LateNightIceCream/ample/docs/hardware/README.md

# Hardware Concept
## Starting Point / Motivation
- Tensai 'Amplifier System 55'

## Requirements
- [ ] >=15W speaker output for at least two speakers (L/R)
- [ ] headphone output
- [ ] volume control
- [ ] front power button
- [ ] source selection
  - line input (single ended)
  - S/PDIF input
  - (maybe) Bluetooth input
- [ ] Microcontroller
- [ ] some LEDs

### Optional
- [ ] reuse tensai transformer
  - its very heavy and takes up a lot of space!
- [ ] Bluetooth input
- [ ] keep input / user interface in direction of uC extendable
- [ ] configuration jumpers on back of case
- [ ] DC input jack

### Case
- either a new wooden case or original Tensai case (bad for BT signal)

## Realization
### ICs

### Block Diagram

### Supply
- make sure to use ferrite beads + caps to decouple individual codec supplies

#### Voltage Levels
| Voltage  | Description |
|---|---|
| 230 VAC  | wall |
| 20.7 VAC | transformer secondary |
| 17 V | class D amplfier voltage |
| 5 V | codec supply |
| 3.3 V | codec supply |
| 3.3 V | uC voltage |

#### Input Current
