LateNightIceCream/ample/docs/hardware/review/README.md

# Hardware Review

## Component Checks
| Component | Symbol | Footprint | Checked | Eng | Note |
|---|---|---|---|-----|---|
| CS42528 | OK | OK | 2022-06-02 | RG  | |
| | NC | | | | |
| | | | | | |

| Abbr. | Meaning |
|---|---|
| OK | Symbol/Footprint was checked and is correct |
| NC | Not Checked |
| NOK | Symbol/Footprint is erroneous |
