LateNightIceCream/ample/docs/hardware/components/opamp/opamp_research.ods

Sheet: opamp
LDO
Requirements
Vin_max | >= 6 V
GBWP | >= 5 MHz
Slew Rate | >= 0.1 V/µs
Differential inp. Voltage | >= 5 V
 |  |  |  |  |  | Noise | RTR | THD | Offset (max)
PartNr | Price | Vin_max | GBWP | Slew Rate | D.inp. Voltage | nV/sqrtHz |  | % | mV
BA4560FJ-GE2 | 0.48 |  | 10 | 4 | 36 | 8 | no | 0.003 | 2.5
LM833DT | 0.57 | 15 | 10 | 7 | 30 | 4.5 | ? | 0.002 | 5
LM4565F-GE2 | 0.45 |  | 10 | 5 | 16 | 5 | ? | 0.0002 | 1.5
NJM4580E | 0.67 | 15 | 15 | 5 | 30 |  | ? | 0.0005 | 3
RC4580QDRQ1 | 0.67 | 15 | 12 | 5 | 30 | 0.8 | ? | 0.0005 | 3
LM833MX/NOPB | 0.89 | 15 | 12 | 5 | 30 | 4.5 | ? | 0.002 | 5
NJM2068 | 0.57 | 15 | 19 | 6 | 30 |  |  | 0.001 | 3 | (reference design)
References
https://www.digikey.de/en/products/filter/linear-amplifiers-instrumentation-op-amps-buffer-amps/687

Sheet: price
part | description | unit price | amount | total price
 |  |  | 3
 |  |  |  | 0
