LateNightIceCream/ample/docs/hardware/components/supply/dcdc_research.ods

Sheet: converter
DC/DC Buck
Requirements
Vin_max | >= 30V
Vout_min | <= 6V
I_out_max | >= 1.7A
f_sw | <= 1 MHz
Parts
PartNr | Price | Vin_max | Vout_min | I_out_max | f_sw / kHz
NCP1587DR2G (https://www.mouser.de/ProductDetail/onsemi/NCP1587DR2G?qs=N5dOQkml4H%252BYCA0xD3fSJw%3D%3D) | 0.836 | 12 | 0.8 |  | 200
NCP3011DTBR2G (https://www.mouser.de/ProductDetail/onsemi/NCP3011DTBR2G?qs=lYuAOLy5nvYYiiWQwbTD2w%3D%3D) | 1.32 | 28 | 3.3 |  | 400 | Fixed 3.3
TPS64203DBVR (https://www.mouser.de/ProductDetail/Texas-Instruments/TPS64203DBVR?qs=Gse6rAGbi78DSy0ANXesIQ%3D%3D) | 1.6 | 6.5 | 1.2 |  | 800
NCV3011DTBR2G (https://www.mouser.de/ProductDetail/onsemi/NCV3011DTBR2G?qs=Pqj8oIac8rVYum8f0f%252BPYA%3D%3D) | 1.59 |  |  |  |  | Fixed 3.3
TL5001IDR | 1.73 | 40 |  |  |  | controller
946-MP4423GQ-P | 2.94 | 30 | 0.8 | 3 | 410
L5972D | 3 | 36 |  | 2 | 250
NR111E | 1.63 | 31 | 0.8 | 4 | 350
AOZ1283PI | 1.72 | 36 | 0.8 | 2.5 | 200..2000 | adjustable fsw
RT7272BGSP | 2.09 | 36 | 0.8 | 3 | 500
RT7272AGSP | 2.09 | 36 | 0.8 | 3 | 500
RT8289GSP | 2.45 | 32 | 1.222 | 5 | 500
R1270S001A-E2-FE | 2.67 | 34 | 0.8 | 3 | 300..2400
MP9943AGQ-P | 2.7 | 36 | 0.8 | 3 | 410
R1276S001A-E2-FE | 2.7 | 30 | 3.15 | 3 | 250..1000
R1276S004A-E2-FE | 2.7 | 30 | 0.7 | 3 | 250..1000
MP4420GJ-P | 2.73 | 30 | 0.8 | 2 | 410
Shortlist
AOZ1283PI | RT7272BGSP
soft start | no diode needed
adjustable frequency | adjustable current limit
vin pad
References
https://octopart.com/search?category_id=4312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
https://www.digikey.de/de/products/filter/pmic-spannungsregler-dc-dc-schaltregler/739

Sheet: inductance
RT7272BGSP
Inductor Value 1 | 30.6944444444444 | uH
Input Voltage | 30
Output Voltage | 17
f_sw | 500000
I_max | 2
Saturation Current | 5
Inductor Value 2 | 48.28797190518 | uH
Input Voltage | 17
Output Voltage | 6
f_sw | 500000
I_max | 0.67
Saturation Current | 3
Parts
Inductor 1
PartNr | Price | L | I | I_sat
104CDMCCDS-330MC | 1.04 | 33 | 4.1 | 5.2
ETQ-P4M330KVC | 1.22 | 33 | 4.2 | 5.6
PA4342.333NLT | 1.37 | 33 | 3.5 | 5
DR127-470-R | 1.44 | 47 | 2.95 | 5.28
Inductor 2
PartNr | Price | L | I | I_sat
HCM1A0805-470-R | 0.49 | 47 | 1.8 | 3.2
IHLP4040DZER470M1A | 0.8 | 47 | 3.3 | 3
104CDMCCDS-470MC | 0.53 | 47 | 3.2 | 4.3
References
https://www.digikey.de/de/products/filter/feste-drosselspulen/71

Sheet: capacitance
Input Capacitance | 2x 10uF
I_RMS 1 | 0.991071249821234 | A
I_max | 2 | A
V_out | 17 | V
V_in | 30 | V
I_RMS 2 | 0.320182690065064 | A
I_max | 0.67 | A
V_out | 6 | V
V_in | 17 | V
Output Capacitance | 7.5 | uF
ESR | 0.05 | Ohm
Current Ripple | 0.6 | A
Voltage Ripple | 0.01 | V
f_sw | 500000 | Hz
Parts
PartNr | Price @10 | V_max | Package (metric)
GRM188R6YA106MA73D | 0.239 | 35 | 1608
GRM188R6YA106MA73D | 0.188 | 35 | 1608
GRM188R6YA106MA73J | 0.188 | 35 | 1608
GRM21BR61H106KE43K | 0.196 | 50 | 2012

Sheet: cost
part | description | unit price | amount | total price
RT7272BGSP | dcdc | 2.09 | 2 | 4.18
HCM1A0805-470-R | inductor | 1.04 | 1 | 1.04
104CDMCCDS-330MC | inductor | 0.49 | 1 | 0.49
GRM188R6YA106MA73D | capacitor | 0.239 | 8 | 1.912
 |  |  |  | 7.622
