LateNightIceCream/ample/docs/hardware/components/supply/ldo_research.ods

Sheet: ldo
LDO
Requirements
Vin_max | >= 6V
Vout_min | <= 5V
I_out_max | >= 0.5
Parts
PartNr | Price | Vin_max | Vout_min | I_out_max | Drop | @ | Remark
AZ1117H-ADJTRE1 | 0.4 | 15 | 1.25 | 1 | 1.25 | 1 | nrnd
AP7366-W5-7 | 0.49 | 6 | 0.8 | 0.6 | 0.3 | 0.6
AZ1084CD-ADJTRG1 | 0.54 | 13.2 | 1.25 | 5 | 1.5 | 5 | 3mA min IL
LM1117MPX-ADJNOPB | 0.56 | 20 | 1.25 | 0.8 | 1.2 | 0.8
LDL212DR | 0.66 | 18 | 0.3 | 1.2 | 0.35 | 1.2
NCP1117IDTAT4G | 0.66 | 20 |  | 1 | 1.2 | 0.8
NCP1117STAT3G | 0.64 | 20 |  | 1 | 1.2 | 0.8
AP2113KTR-G1 | 0.35 | 5.5 |  | 0.6 | 0.2
Shortlist | PSRR @ 500kHz | IL_min
AZ1117H-ADJTRE1 | 30dB | 0.8
AP7366-W5-7 | 25dB | 0
LDL212DR | 40dB | 0
needs to dissipate max 0.6W
should be safe
References
https://www.digikey.de/de/products/filter/pmic-spannungsregler-linear/699

Sheet: price
part | description | unit price | amount | total price
LDL212DR | ldo | 0.66 | 2 | 1.32
 |  |  |  | 1.32
