LateNightIceCream/ample/docs/hardware/components/README.md

# Components
spreadsheets with component research
