LateNightIceCream/ample/(threads)

Thread 1 (2022-10-05):

dac output filter

LateNightIceCream, 2022-10-05:
https://www.ti.com/lit/an/sbaa322/sbaa322.pdf

-> watch out that all possible sampling frequencies are supported!

LateNightIceCream, 2022-10-06:
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

use the bottom topology with the optional C23 capacitor. This will provide a lot of flexibility

LateNightIceCream, 2023-06-18:
I think I will go for a differential output since there is a negative supply anyways and the headphone amplifier can accept a differential input. I will look into the codec's design guide

LateNightIceCream, 2023-06-21:
now using a fully differential setup for rev 00.01

Closed 2023-06-21.

Thread 7 (2023-07-12):

Add input voltage reverse polarity protection

LateNightIceCream, 2023-07-12:

Thread 8 (2023-07-14):

Fix ESP32 thermal relief and vias

LateNightIceCream, 2023-07-14:
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

just noticed that something went wrong with the thermal reliefs on the ESP32 module.

Thread 16 (2023-08-10):

Figure out ESP Module alternative

LateNightIceCream, 2023-08-10:
This is just a soldering issue.
I put the ESP WROVER module in the reflow oven and the pads did not reflow properly. I guess it probably sucked up all the heat so I had to solder it and some components around it by hand. An alternative would be to use a different uC (not preferred) or perhaps just a through hole pin header to mount a devkit but this might not be possible due to the height.

Thread 18 (2023-08-10):

Change MAX660 capacitor value

LateNightIceCream, 2023-08-10:
For some reason the charge pump cap is 100nF instead of e.g. 10uF

LateNightIceCream, 2023-08-10:
perhaps also add a parallel electrolytic capacitor

Thread 20 (2023-08-12):

Add pin header for I2C testing

LateNightIceCream, 2023-08-12:
Just something that I was missing
