LateNightIceCream/ample/(commit log)

2022-05-12 kicad init
    [ample.kicad_pcb, ample.sch]
2022-05-13 separate pcb projects
    [ample_control.kicad_pcb, ample_control.sch, ample_supply.kicad_pcb, ample_supply.sch]
